RandyStockberger/kicad-attiny-servo/README.md

# kicad-attiny-servo
KiCad files for an attiny4313 model railroad turnout controller driven by servos
