RandyStockberger/kicad-attiny-servo/SmallServoRelay.xls

Designator | Package | Quantity | Designation | On Hand | Digikey P/N | Order
IC1 | SOIC-20 | 1 | ATTINYx313-S | 0 | ATTINY4313-SU-ND | 13
U1 | SOT-23-5 | 1 | PAM2305DABADJ | 10
Q1,Q2,Q3,Q4 | SOT-23 | 4 | N-MOSFET | 0 | BSS316N H6327CT-ND | 100
Q5,Q6 | SOT-23 | 2 | 2N3904 | 30 | 568-4510-1-ND
C5 | C 0805 | 1 | 100pF | 9 | 1276-2568-1-ND
C9 | C 0805 | 1 | 0.1uF | 77
C1,C2,C6,C7,C8,C10,C11 | C 0805 | 8 | 10uF | 85 | 1276-6456-1-ND
C3 | C_Radial_D5_L11_P2 | 1 | 100uF | 7
C4 | C_Radial_D10_L16_P5 | 1 | 1000uF | 8
R6,R7,R8,R9,R14,R20,R21,R22,R23 | R 0805 | 9 | 120 | 0 | RMCF0805JT120RCT-ND | 250
R15 | R 0805 | 1 | 330 | 10 | RMCF0805JT330RCT-ND | 100
R2,R5,R12,R13,R18,R19 | R 0805 | 6 | 1K | 109 | RMCF0805JT1K00CT-ND
R24,R26 | R 0805 | 2 | 2K7 | 0 | RMCF0805JT2K70CT-ND | 100
R1,R25,R27,R28,R29 | R 0805 | 5 | 10K | 1000
R10,R11,R16,R17 | R 0805 | 4 | 22K | 30 | RMCF0805JT22K0CT-ND | 100
R4 | R 0805 | 1 | 120K | 40
R3 | R 0805 | 1 | 540K | 22
D1,D2,D3 | SOD-323 | 3 | Schottky | 20 | NSVR0320MW2T1GOSCT-ND | 40
D4 | LED_0805 | 1 | LED – Yellow | 0 | 475-2560-1-ND
D5 | LED_0805 | 1 | LED – Green | 25
L1 | Bourns-Inductor-SRN4026 | 1 | 4.7uH | 10
P1 | Phoenix-Combicon-2.5mm-2 | 1 | Power | 50
P5.P6 | Phoenix-Combicon-2.5mm-3 | 2 | FROG 1 | 28
P7,P8 | Pin_Header_Straight_1x03 | 2 | SERVO1 | 40
P3,P4 | Pin_Header_Straight_1x04 | 2 | CONN_01X04 | 40
P2 | Pin_Header_Straight_2x03 | 1 | ISP | 40
RLY1,RLY2 | Relay_SPDT-Form_C | 2 | SPDT | 0 | PB2113-ND | 6
SW1,SW2 | SW_PUSH_SMALL | 1 | Button, Tactile, NO | 50
Q1,Q2 | SOT-23 | 2 | NPN 3904
R1,R4 | R 0603 | 2 | 620, 0.25W | 10 | P620BZCT-ND
R2,R3 | R 0603 | 2 | 100K | 10 | 311-100KGRCT-ND
 | R 0603 | 2 | 49.9K | 10 | 311-49.4KGRCT-ND
 | R 0603 | 2 | 200K | 10 | 311-200KGRCT-ND
C1,C2 | C 0603 | 2 | 10uF | 6 | 587-3238-1-ND
 | C 0603 | 2 | 4.7uF | 10 | 311-1785-1-ND
D1,D2 | LED 0603 | 2 |  | 5 | 732-4979-1-ND
D3 | Bridge Rect. | 1 |  | 5 | BGX50AE6327HTSA1CT-ND
