RandyStockberger/kicad-attiny-servo/SmallServoRelay.kicad_pcb

## KiCad design SmallServoRelay.kicad_pcb (2017-01-31)

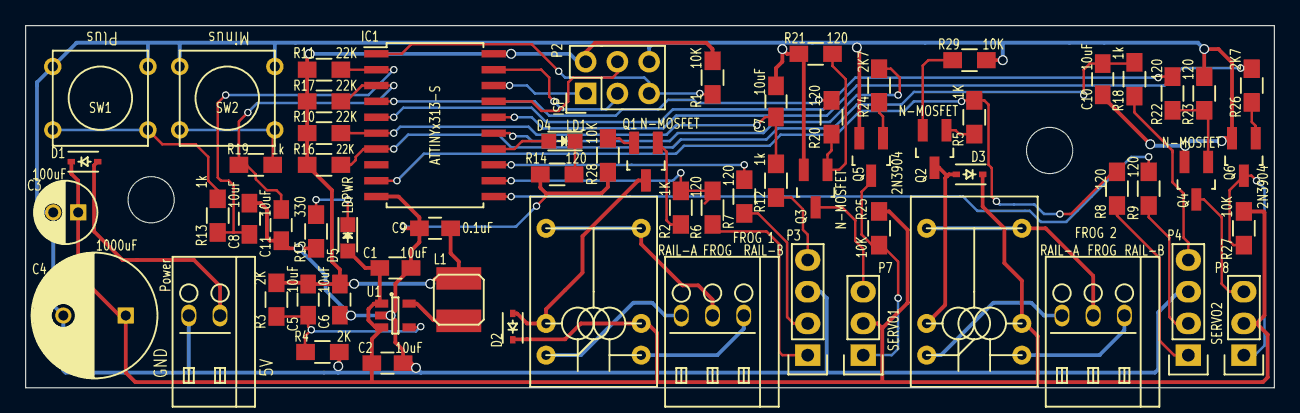
[picture p1: board SmallServoRelay.kicad_pcb from above]

Board: 2 copper layers, 100.0 x 29.0 mm, 66 parts (0 on the bottom side), 53 nets.

Parts:
C1, C2, C5, C6, C7, C8, C10, C11: 10uF; C_0805_HandSoldering
C3: 100uF; C_Radial_D5_L11_P2
C4: 1000uF; C_Radial_D10_L16_P5
C9: 0.1uF; C_0805_HandSoldering
D1: Diode; SOD-323
D2, D3: Schottky; SOD-323
D4: LD1; LED_0805
D5: LDPWR; LED_0805
IC1: ATTINYx313-S; SOIC-20_7.5x12.8mm_Pitch1.27mm
L1: INDUCTOR; Bourns-Inductor-SRN4026
P1: Power; Phoenix-Combicon-2.5mm-2
P2: ISP; Pin_Header_Straight_2x03
P3, P4: CONN_01X04; Pin_Header_Straight_1x04
P5: FROG 1; Phoenix-Combicon-2.5mm-3
P6: FROG 2; Phoenix-Combicon-2.5mm-3
P7: SERVO1; Pin_Header_Straight_1x03
P8: SERVO2; Pin_Header_Straight_1x03
Q1, Q2, Q3, Q4: N-MOSFET; SOT-23_Handsoldering
Q5, Q6: 2N3904; SOT-23_Handsoldering
R1, R25, R27, R28, R29: 10K; R_0805_HandSoldering
R2, R5: 1K; R_0805_HandSoldering
R3, R4: 2K; R_0805_HandSoldering
R6, R7, R8, R9, R14, R20, R21, R22, R23: 120; R_0805_HandSoldering
R10, R11, R16, R17: 22K; R_0805_HandSoldering
R12, R13, R18, R19: 1k; R_0805_HandSoldering
R15: 330; R_0805_HandSoldering
R24, R26: 2K7; R_0805_HandSoldering
RLY1, RLY2: SPDT; Relay_SPDT-Form_C
SW1: BTN-PLUS; SW_PUSH_SMALL
SW2: BTN-MINUS; SW_PUSH_SMALL
U1: PAM2305DABADJ; SOT-23-5

Connections:
+3V3: C5.1, C6.1, C9.1, IC1.20, L1.2, P2.2, R1.2, R3.2, R10.1, R11.1, R16.1, R17.1
+5V: C1.1, C2.1, C3.1, C4.1, D1.1, D2.1, D3.1, D5.2, P7.2, P8.2, R25.2, R27.2, RLY1.2, RLY2.2, U1.1, U1.3
/BTMINUS: C11.1, IC1.3, R17.2, R19.2
/BTPLUS: C8.1, IC1.2, R11.2, R13.2
/BTS1: C7.1, IC1.6, R10.2, R12.2
/BTS2: C10.1, IC1.7, R16.2, R18.2
/CBT1: P3.4, R12.1
/CBT2: P4.4, R18.1
/FROG1: P5.2, RLY1.5, RLY1.6
/FROG2: P6.2, RLY2.5, RLY2.6
/LD1A: IC1.12, R2.2, R6.2
/LD1B: IC1.13, R7.2
/LD2A: IC1.9, R5.2, R8.2
/LD2B: IC1.11, R9.2
/LED1: D4.2, IC1.14
/MISO: IC1.18, P2.1
/MOSI: IC1.17, P2.4
/RAIL-A1: P5.1, RLY1.1
/RAIL-A2: P6.1, RLY2.1
/RAIL-B1: P5.3, RLY1.10
/RAIL-B2: P6.3, RLY2.10
/SCK: IC1.19, P2.3
/SV1: IC1.15, R24.2
/SV1EN: IC1.4, R20.2
/SV1GND: P7.3, Q3.3
/SV1SIG: P7.1, Q5.3, R25.1
/SV2: IC1.16, R26.2
/SV2EN: IC1.5, R22.2
/SV2GND: P8.3, Q4.3
/SV2SIG: P8.1, Q6.3, R27.1
/~RESET: IC1.1, P2.5, R1.1
GND: C1.2, C2.2, C3.2, C4.2, C6.2, C7.2, C8.2, C9.2, C10.2, C11.2, IC1.10, P1.2, P2.6, P3.3, P4.3, Q3.2, Q4.2, Q5.2, Q6.2, R4.1, R14.2, R15.2, R21.1, R23.1, R28.1, R29.1, SW1.2, SW2.2, U1.2
unnamed: C5.2, R3.1, R4.2, U1.4
unnamed: D1.2, P1.1
unnamed: D2.2, Q1.3, RLY1.9
unnamed: D3.2, Q2.3, RLY2.9
unnamed: D4.1, R14.1
unnamed: D5.1, R15.1
unnamed: L1.1, U1.5
unnamed: P3.1, R6.1
unnamed: P3.2, R7.1
unnamed: P4.1, R8.1
unnamed: P4.2, R9.1
unnamed: Q1.1, R2.1
unnamed: Q1.2, R28.2
unnamed: Q2.1, R5.1
unnamed: Q2.2, R29.2
unnamed: Q3.1, R20.1, R21.2
unnamed: Q4.1, R22.1, R23.2
unnamed: Q5.1, R24.1
unnamed: Q6.1, R26.1
unnamed: R13.1, SW1.1
unnamed: R19.1, SW2.1
