RandyStockberger/kicad-attiny-servo/(notices)

Notices in the files:
SmallServoRelay.kicad_pcb:
Copyright 2016, Randy Stockberger
